Nitish5196/Pocket-watch/README.md

# Pocket Watch- KN
Its a mini pocket watch with a round display , a vibrating motor , a battery and a xiao esp32-C6 . and the best part? it charges wirelesslyyyyy
ikr so cool . so i designed the pcb in kicad , the case in fusion 360 and the firmware in vs code and ardunio ide oh about the firmware i forgot to tell you wht it does.
### Firmware:
- it has a deep sleep mode so most of the time its sleeping to conserve battery , it wakes up at when you shake it aggressively 
- when it turns on in the mrng and it broadcasts its own local wifi , you connect to it , open the webpage and a prompt pops up asking for day order or holiday
once you enter tht , it will show the tabular form of the time table of the day and sends a message to the watch and turns off
- during normal time the screen stays black and shows nothing , but you can shake to wake it up make it show the time and current/upcoming class.
- automatically 5mins before and at the start of the class it lights up and notifies you by turning on and vibrating
- Right before i leave for school it turns on and once i submit the day order the wifi turns off and it goes back to sleep
- THIS IS DESIGNED ACCORDING TO MY SCHOOL TIME TABLE SO YOU SHOULD PROBABLY MAKE CHANGES TO THE FIRMWARE IF YOU'RE PLANNING TO USE IT 
## PCB 





## Case (will make changes once the component's size are measured)




## BOM
## Bill of Materials (BOM)

| Part | Quantity | Total Cost(USD) | Vendor | Link |
|---|---:|---:|---|---|
| Flat 1034 Mobile Phone Vibrator Motor | 1 | $0.31 | Robu | [link](https://robu.in/product/flat-1027-mobile-phone-vibration-motor/) |
| STMicroelectronics LIS3DH 3-Axis Digital Accelerometer | 1 | $2.7 | Robocraze | [link](https://robocraze.com/products/7semi-lis3dh-triple-axis-mems-accelerometer-breakout-module-i2c-spi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) |
| GoldenMorning GC9A01P 1.28" 240×240 SPI Round Display | 1 | $5.06 | Robu | [link](https://robu.in/product/goldenmorning-gc9a01-7p-240x240-spi-1-28-inch-round-display-module/) |
| 2N2222 NPN Transistor | 5 | $0.12 | Robu | [link](https://robu.in/product/2n2222-npn-transistor-pack-of-20/) |
| 1kΩ 1W Metal Film Resistor | 6 | $0.13 | Robu | [link](https://robu.in/product/1k-ohm-1w-metal-film-resistor-pack-of-40/) |
| 1N4148 Small Signal Diode | 2 | $0.15 | Robu | [link](https://robu.in/product/1n4148-tap-vishay-1n4148-tap-small-signal-diode-single-100-v-150-ma-1-v-8-ns-2-a/) |
| Seeed Studio XIAO ESP32C3 | 1 | $6.4 | Robocraze | [link](https://robocraze.com/products/seeed-studio-xiao-esp32c3?variant=46039428366560) |
| 3.7V 300mAh LiPo Battery | 1  | $4 | Amazon | [link](https://www.amazon.in/gp/product/B0FGFK19DF/ref=ewc_pr_img_1?smid=A3QQB9C2QXM7ZJ&psc=1) |
| Power/kill Switch | 1 | $0.2 | robu | [link](https://robu.in/product-category/slide-switches/)| 
| Custom PCB | 1 | $10.5 | Lion Circuits | [link](https://www.lioncircuits.com/quote) |
| 3d Case | 2 | $7| Printing legion  | [join Hack Club!!](https://printlegion.hackclub.com/)|
| **TOTAL** | | **$37.6** | (incl shipping:$1)| |
