Nitish5196/Pocket-watch/BOM for Pocket Watch - watch pcb-BOM.csv

Id | Designator | Footprint | Quantity | Designation | Supplier and ref | Price
1 | D1 | D_DO-35_SOD27_P7.62mm_Horizontal | 1 | 1N4148 | https://robu.in/product/1n4148-tap-vishay-1n4148-tap-small-signal-diode-single-100-v-150-ma-1-v-8-ns-2-a/ | $0.15
2 | J1 | PinHeader_1x07_P2.54mm_Vertical | 1 | DISPLAY | https://robu.in/product/goldenmorning-gc9a01-7p-240x240-spi-1-28-inch-round-display-module/ | $5.06
3 | J2 | PinHeader_1x02_P2.54mm_Vertical | 1 | BATTERY | https://www.amazon.in/gp/product/B0DY89KG26/ref=ox_sc_saved_image_2?smid=AJ6SIZC8YQDZX&psc=1 | $4.00
4 | J4 | PinHeader_1x02_P2.54mm_Vertical | 1 | VIBRATING MOTOR | https://robu.in/product/flat-1027-mobile-phone-vibration-motor/ | $0.31
5 | J5 | PinHeader_1x05_P2.54mm_Vertical | 1 | ACCELEROMETER | https://robocraze.com/products/7semi-lis3dh-triple-axis-mems-accelerometer-breakout-module-i2c-spi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 | $2.70
6 | Q1 | TO-92_Inline | 1 | 2N2222 | https://robu.in/product/2n2222-npn-transistor-pack-of-20/ | $0.12
7 | R1 | R_0805_2012Metric | 1 | 1K | https://robu.in/product/1k-ohm-1w-metal-film-resistor-pack-of-40/ | $0.13
8 | SW1 | SW_DPDT_CK_JS202011JCQN | 1 | POWER SWITCH | https://robu.in/product-category/slide-switches/ | $0.20
9 | U1 | XIAO-ESP32-C6-SMD | 1 | XIAO-ESP32-C3-SMD | espc2 c3 xiao | $6.40
10 | PCB | : | PCB |  | https://www.lioncircuits.com/quote | $10.50
11 | 3D case |  |  |  | printing legion | $7.00
 | Shipping |  |  |  |  | $1.00
 | Total |  |  |  |  | $37.60
