Nitish5196/Pocket-watch/cad/bottom case final.step

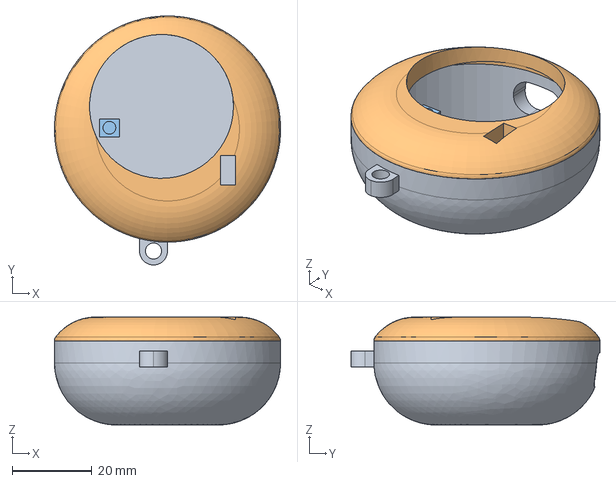
[picture p1: CAD file, 2026-11-06]
cad/bottom case final.step
56.6 x 62.3 x 27.0 mm
