Nitish5196/Pocket-watch/production/watch pcb.step

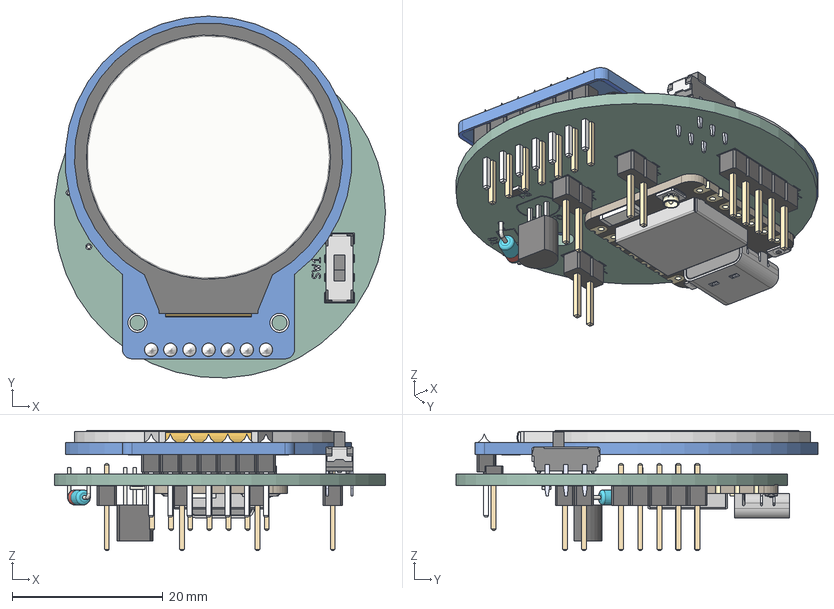
[picture p2: CAD file, 2026-10-30]
production/watch pcb.step
43.9 x 48.0 x 15.9 mm
PinHeader_1x07_P254mm_Vertical
JS202011CQN
PinHeader_1x02_P254mm_Vertical x 3
TO-92_Inline_Narrow
PinHeader_1x05_P254mm_Vertical
BOSS-EXTRUDE14_8_
BOSS-EXTRUDE7_4_
BOSS-EXTRUDE7_3_
BOSS-EXTRUDE14_4_
BOSS-EXTRUDE14_2_
BOSS-EXTRUDE14_11_
BOSS-EXTRUDE7_7_
BOSS-EXTRUDE14_9_
BOSS-EXTRUDE14_3_
BOSS-EXTRUDE14_7_
MIRROR2
BOSS-EXTRUDE14_5_
BOSS-EXTRUDE14_12_
BOSS-EXTRUDE7_8_
BOSS-EXTRUDE7_1_
BOSS-EXTRUDE14_10_
BOSS-EXTRUDE7_9_
BOSS-EXTRUDE14_6_
BOSS-EXTRUDE14_1_
BOSS-EXTRUDE7_6_
BOSS-EXTRUDE7_2_
CUT-EXTRUDE5
BOSS-EXTRUDE7_5_
U.FL Connector v1
Shield
SKTAAAE010 v1 x 2
KH5220-A36 (Ceramic Antenna) v2
D_DO-35_SOD27_P7.62mm_Horizontal
R_0805_2012Metric
watAEB0_silkscreen x 2
watAEB0_PCB
