Nitish5196/Pocket-watch/cad/Pocket watch shell-bottom with pcb_.step

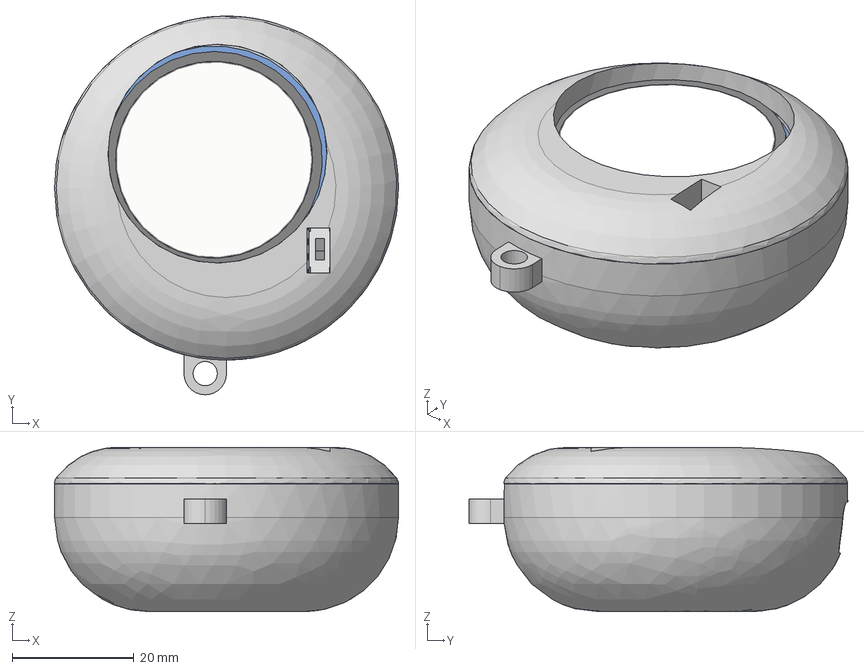
[picture p3: CAD file, 2026-10-30]
cad/Pocket watch shell-bottom with pcb_.step
56.6 x 62.3 x 27.0 mm
