Nitish5196/Pocket-watch/(list of files, cad)

Other CAD files:
cad/top case-final.step
cad/bottom case.step
cad/top case.step
cad/Pocket watch shell-top.step
cad/Pocket watch shell-bottom.step
cad/Pocket watch shell.f3z
cad/complete assembly_.f3z
