Nitish5196/Pocket-watch/watch pcb/watch pcb.kicad_pcb

## KiCad design watch pcb/watch pcb.kicad_pcb (2026-10-30)

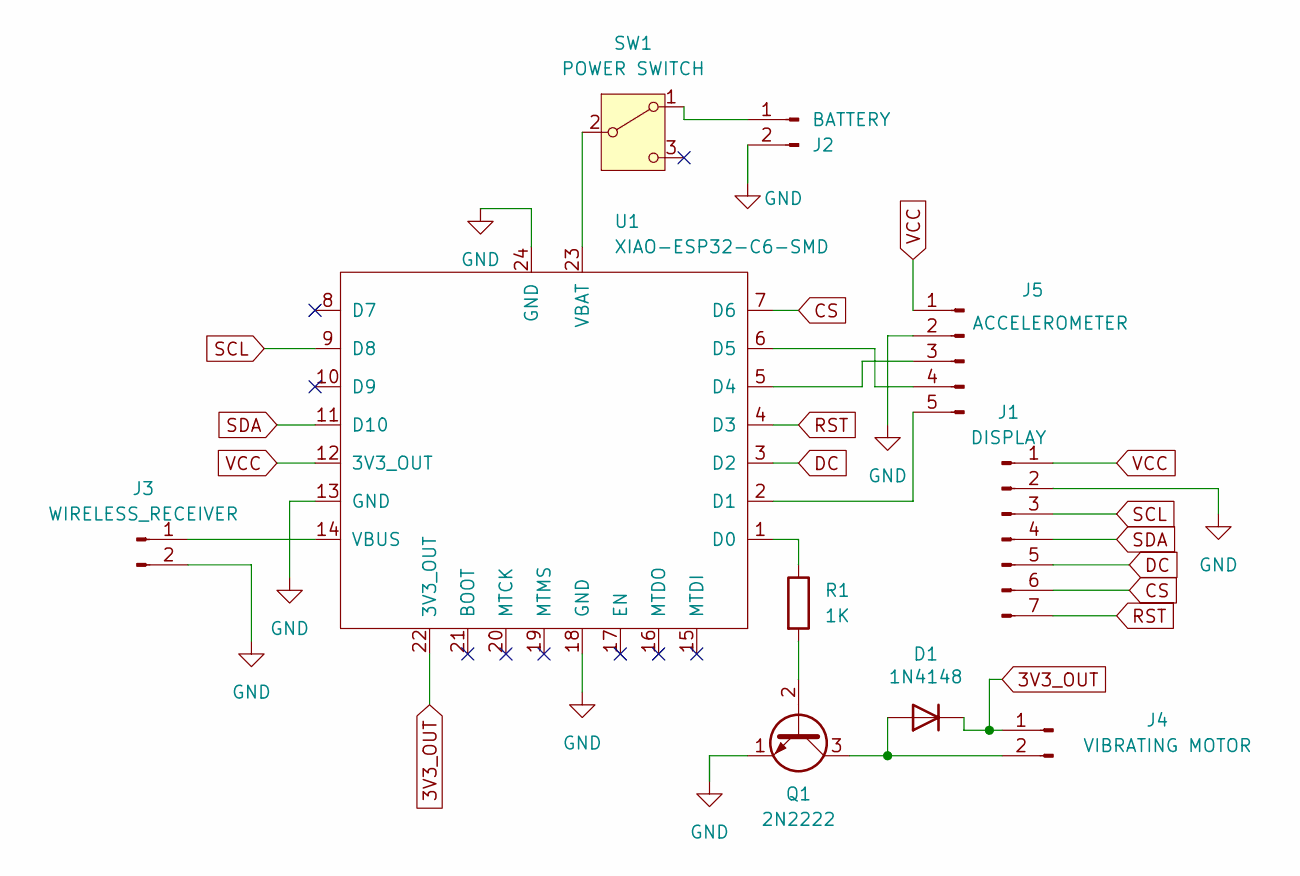
[picture p4: schematic watch pcb.kicad_sch]

Parts:
D1: 1N4148; D_DO-35_SOD27_P7.62mm_Horizontal
J1: DISPLAY; PinHeader_1x07_P2.54mm_Vertical
J2: BATTERY; PinHeader_1x02_P2.54mm_Vertical
J3: WIRELESS_RECEIVER; PinHeader_1x02_P2.54mm_Vertical
J4: VIBRATING MOTOR; PinHeader_1x02_P2.54mm_Vertical
J5: ACCELEROMETER; PinHeader_1x05_P2.54mm_Vertical
Q1: 2N2222; TO-92_Inline
R1: 1K; R_0805_2012Metric
SW1: POWER SWITCH; SW_DPDT_CK_JS202011JCQN
U1: XIAO-ESP32-C6-SMD

Connections:
3V3_OUT: D1.1 (K), J4.1, U1.22 (3V3_OUT)
CS: J1.6, U1.7 (D6)
DC: J1.5, U1.3 (D2)
GND: J1.2, J2.2, J3.2, J5.2, Q1.1 (E), U1.13 (GND), U1.18 (GND), U1.24 (GND)
unnamed: D1.2 (A), J4.2, Q1.3 (C)
unnamed: J2.1, SW1.1 (A)
unnamed: J3.1, U1.14 (VBUS)
unnamed: J5.3, U1.5 (D4)
unnamed: J5.4, U1.6 (D5)
unnamed: J5.5, U1.2 (D1)
unnamed: Q1.2 (B), R1.2
unnamed: SW1.2 (B), U1.23 (VBAT)
unnamed: R1.1, U1.1 (D0)
RST: J1.7, U1.4 (D3)
SCL: J1.3, U1.9 (D8)
SDA: J1.4, U1.11 (D10)
VCC: J1.1, J5.1, U1.12 (3V3_OUT)

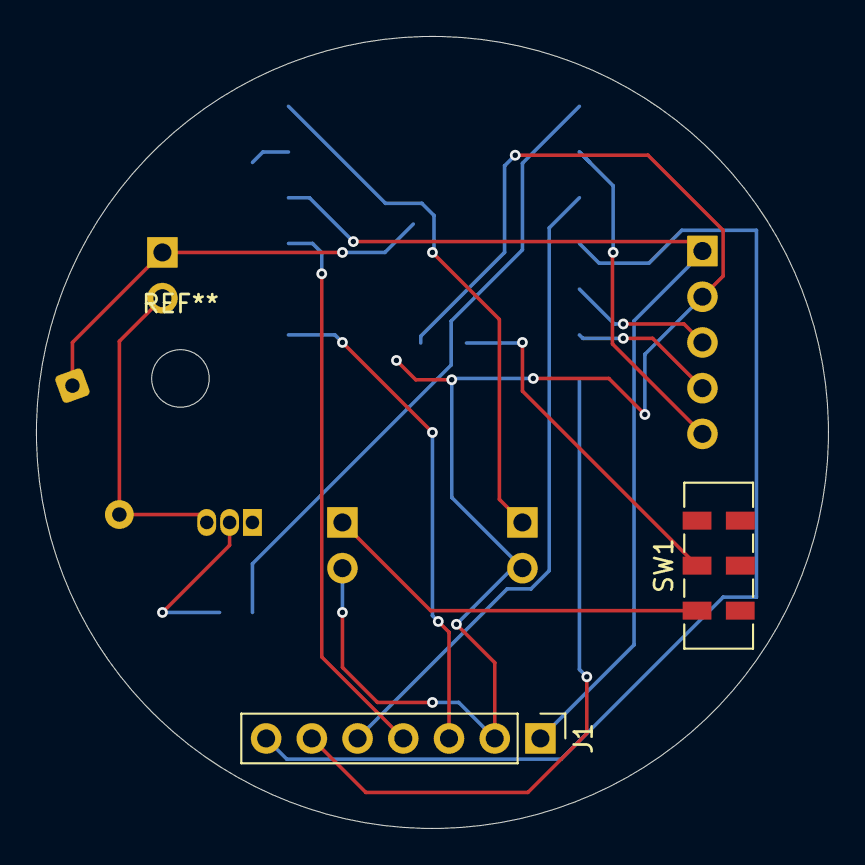
[picture p5: board watch pcb.kicad_pcb from above]

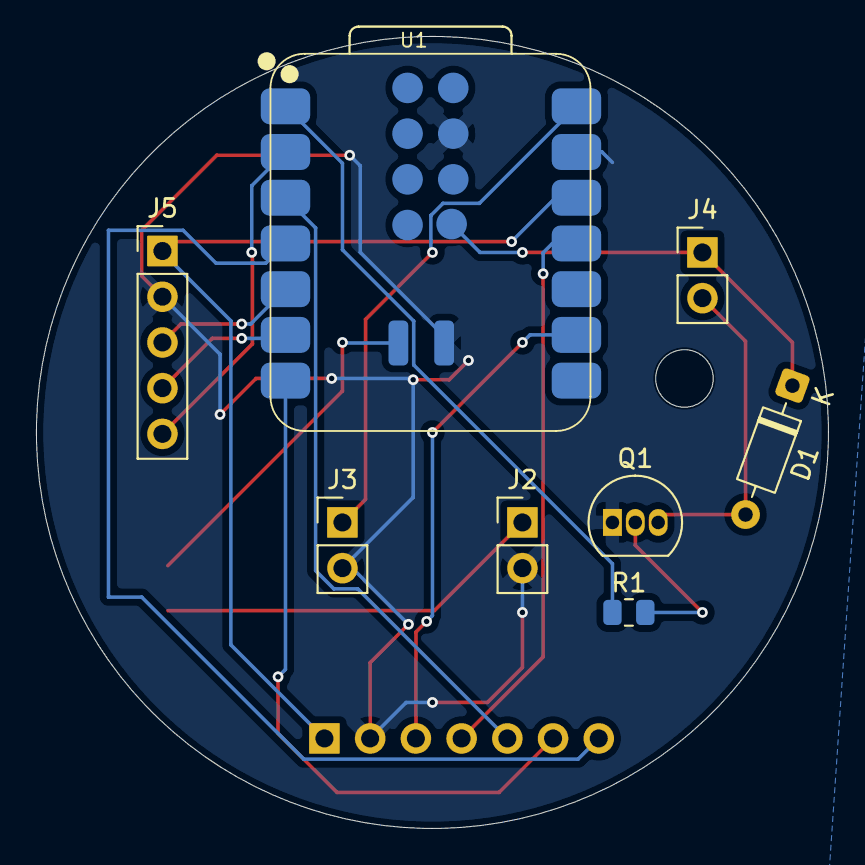
[picture p6: board watch pcb.kicad_pcb from below]

Board: 2 copper layers, 44.0 x 44.0 mm, 10 parts (8 on the bottom side), 17 nets.
