Nitish5196/Pocket-watch/Journal.md

---
title: "KN-Pocket watch"
github: "https://github.com/Nitish5196/Pocket-watch"
description: "hii Kn-Pocket watch is a compact pocket watch which displays the time the class you have to attend/remeinders it has a deep sleep mode and you have to shake it to wake it up. it also has a vibrating motor to alert you when its time to do smth"
created_at: "2026-10-21"
total_time: "16.2Hrs"
---
## Oct 21 2026 - 8:20am: <journal Started adding components to cart>

Hiiii i selected all the components that i would need to make this project and added them to the cart , you can find the cart images below . you might wonder whts he doin with some random android wireless charger, the thing is i REALLY want to make this wireless but i cant find any wireless receiver online (why is everyone selling wireless charginf pads without receivers? what are you charging without a receiver)anyways so yea ill be using the wireless coil and pcb from tht phone charger to charge this project and another thing Rudy might say is "why do you have six 1K resistors in your cart if you only need one ?Im not funding that" thts because robu has a stupid min cart value thing tht they wont accept anything under 10inr( $.10) and the resistors,NPN and transistor cost like 2inr($0.02) so i added more to get to the min value .







**Total time spent: 1h 27mins**

## Oct 21 2026 - 10:00am: <PCB>
i used the xiao rp2040 symbol first but then i realised it didnt have a lot of pins like battery and stuff so i went to seeed studio's website to download the esp32 c6 symbol and footprint . then i realised i would not be able to solder the LIS3DH's pins so im using a breakout board for it and i changed the resistor from THT to SMD 
Sooo i made a few changes to the cart 

Finished the Schematic and added the footprints to it 
finding the right components and its footprint it super hard
NOOOOOOOOOOOOOOOOOOOOOOOOOOOOOOOOOOOOOOOOOOOOOOOOOOOOOOOOOOOOOOOOOOOOOOOOOOOOOOOOOOOOOOOOOOOOOOOOOOOOOOOOOOOOOOOOOOOOOooooooo the finished pcb (it was almost done i even added the 3d step of display and esp32 and aligned them ) it was few mins away from being finished , i didnt even get a "Kicad not responding" it just randomly closed and the restore backup folde has only schematic WHICH I ALREADY SAVED :/ ill do it again after lunch 

**Total time spent : 4hrs 35mins**

## Oct 21 2026 - 3:10pm: <PCB completed>
So i updated the pcb from schematic , created a 44mm diameter circular edge cuts , routed the components and added GND pour on the B.Cu and completed the schematic with ZERO DRC errors😼





 i also added the 3d steo of esp32, display and the switch. , thts ot the PCB IS DONE!! i might use  jumper cables/normal copper cables  to solder the pcb and the accelerometer
 
 



Now we need to work on the firmware and case

**Total time spent :1hour**

## Oct 27 2026 <Case almost done>
Hiiii so i have been working on the case for the past week but i didnt track time properly but this is how it looks now 





i added 4 holes to add magnets to the lid and bottom case i MIGHT add hinges to them later , the usb port is accessible and i made the whole case in a round shape .rn it looks a bit ugly tbh but its alright cause this is just a rough case to get this submitted , the website of the components doest have the exact measurement so ill make changes to this case once i get the components and pcb to ensure the watch fits perfectly in its case . this is how the case looks as of now
### so whts left?
- need to add mounting holes to the pcb and supports for it in the case
- need to write a rough firmware for it AND IT WILL BE DONEEEEEEEEEEEEEE

**Time Spent : 3h**

## Oct 28 2026 <finish cad?>
so i added 3.2mm mounting hole under the display , i added only 1 because there is no space on the pcb . this is how it looks 


##BTW these are the cases i made for this pocket watch

V1 
V2 
V3(final ver)
Added support for the mounting hole 
added hole for switch ( idk how to extrude the object but somehow learned it , i didnt know in a assembly design everytime i created a new component its a new part design , i was tryin to extrude in another part design .dumb me lol)
i added key hole to the case so i can attach a keyring to it later if needed




### CASE IS DONE LETS GOOOOOOOOOOOOOOOOOOOOOOOOOOOOOOOOOOOOOOOOOO <FIRMWARE issues>

ill work on firmware tmrw cause i spent more than 1hr to download the libraries but it just keeps downloading, it might be a bug or a hardware limitation idk. "Hiii i donwloaded the Adafruit GC9A01A and Adafruit LIS3DH library . it takes too long to download im not sure if this is a problem with Ardunio IDE or my computer so i might use PlatformIO in VS code instead"



**Time Spent : 1hr**
## Oct 30 2026 <firmware stuff>
i'm not able to download any libraries cause its takin too long and slowing my potato laptop so ill install them laer when im free , rn im facing another problem , Displaying the time table . my school follows Day order Timetable so i cant use "if monday -display this" cause day orders may fall on any day of the week and i get a lot of holidays so i need to connect this to my phone to skip the day order and mark it as holiday so it gets display the next working day ( this could be solved by adding a small push button but accidental push may cause it to get changed and im lazy to change my pcb and case cause I NEED TO FINISH THIS ASAP )
### So im planning to make a simple webpage to control the day order on the watch like everyday i wake up and choose the day order on my phone before heading to school.
### Here is the logic for the code below :
- At 6:20 the watch wakes up and starts the Wifi web , ill open the webpage anytime between 6:20-7:00am and select the day order or mark as holiday and save it . the wifi shuts off and the batetry goes into sleep mode to save battery .at 7am even if i didnt enter the day order or mark as holiday the watch will go into sleep mode
- At 7:50am it displays the time and period and the period ends at 9am . at 7:55 it will show "Next: chem " and the second period ends at 9:45 am . from 9:45m to 10 am its break so at 9:55 it will display " next-Web application class 10:00am to 10:45am" like this ill upload each timetable and it will appear 5mins before the class starts and it will also vibrate 5mins before and once the class starts . 
- During the school hrs i would be able to shake the watch to make it display the current time ,subject and when it starts/ends 
- at 3pm school ends so the watch enters deep sleep mode at 4pm and wont turn on until you shake it Very aggressively and the internal , it will automatically turn on and display the webpage at 6:20am and syncs to know the current day order
### so whats left?
- finish the code
- make a simple webpage with html and js for now
## finished the code <done yay>
okay so the code is done , i used simple html and js cause thts all ik , i might use css to make it look it later ,for now if it works it works . 
 




**Total time spent:3.5hrs** 
## Nov 6 <Made changes to project>
###Changes to CAD



So i rezised the lipo by 0.5 so it fits in the 3d model and irl it actually fits in this 
adding hinges to this would be hard ig since the top case is so thin , ill experiment with that once i get a 3dp



### Changes to PCB 
I wont be using the wireless feature anymore but i dont want to remove it from the PCB incase i  decide to add it later in the future so ill remove the wireless receiver and transmittor from the cart and BOM but ill keep the footprint for it in the PCB , since it will function normally without adding the receiver and its cool to have a upgradable watch

### BOM 


Now that the wireless charging components are gone , the BOM is more cost optimized ig . and it might even go lesser than this .  the $10usd for case is just an aprox estimate , ill check with someone from priniting legion and will update it soon!

**Total Time Spent:0.7hrs**
