Nitish5196/Pocket-watch/(commit log)

2026-11-06 final cad ig
    [bottom case final.step, top case-final.step]
2026-11-12 Final BOM
